prrtzel/MCD-Project/Rev1/Resources/Weekly Reports/MCD Weekly Report 2.docx

Microcomputer Design

Dr. Joonwan Kim

1/24/2024

Design Report #2

1. Total time spent this week: 6 hours (from this week and winter break)
2. Accomplishments
  a. I updated the schematic and got everything connected except power and the DUART
  b. Most of the parts are picked out and ready to go
3. Planned Work
  a. This week I plan to finish the schematic and BOM in order to start ordering parts as soon as possible.
  b. Any parts that are set in stone I will also go ahead and order this week.
4. Project Completion
  a. Hardware: 20%
  b. Software: 35% (program reads and writes to memory and displays the output)
