prrtzel/MCD-Project/Rev1/Resources/Weekly Reports/MCD Weekly Report 3.docx

Microcomputer Design

Dr. Joonwan Kim

1/30/2024

Design Report #3

1. Total time spent this week: 7.25 hours
2. Accomplishments
  a. I finished the schematic this week while fixing / verifying some interesting design choices
3. Planned Work
  a. This week I plan to purchase all of the parts
  b. I plan to start PCB design and pick out small parts (resistors, capacitors, etc.)
4. Project Completion
  a. Hardware: 30%
  b. Software: 35% (program reads and writes to memory and displays the output)
5. Help from Lab Tech
  a. 1/29/23 – asked questions about DUART rx and tx lines and received some guidance.
  b. 1/31/24 – Joao reviewed the schematic and corrected some decoupling capacitors and double checked everything
