prrtzel/MCD-Project/Rev2/HW/Altium/Imported MCD_Rev2/MCD_Rev2_1.png

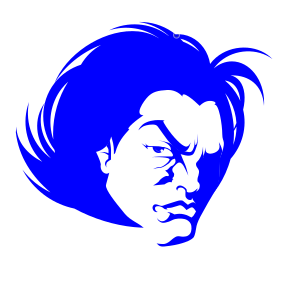
Rev2/HW/Altium/Imported MCD_Rev2/MCD_Rev2_1.png
