prrtzel/MCD-Project/Rev1/Resources/smallComponents.txt

small components
0805 capacitors and LED's
