prrtzel/MCD-Project/Rev2/HW/imported/CLOCK/ECS-100AX-080.step

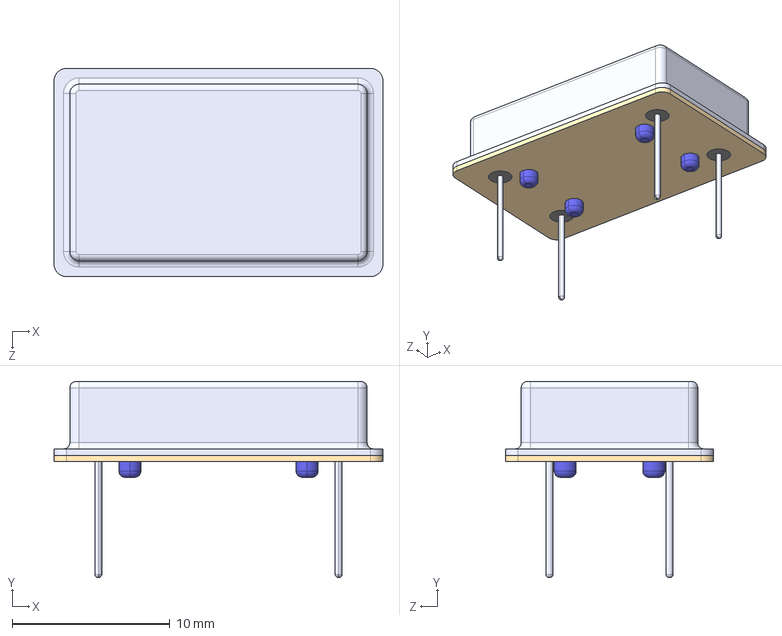
[picture p2: CAD file, 2024-04-25]
Rev2/HW/imported/CLOCK/ECS-100AX-080.step
20.9 x 12.4 x 13.2 mm
