prrtzel/MCD-Project/Rev2/HW/imported/CONNECTOR/18PIN/TD-109-T-A.step

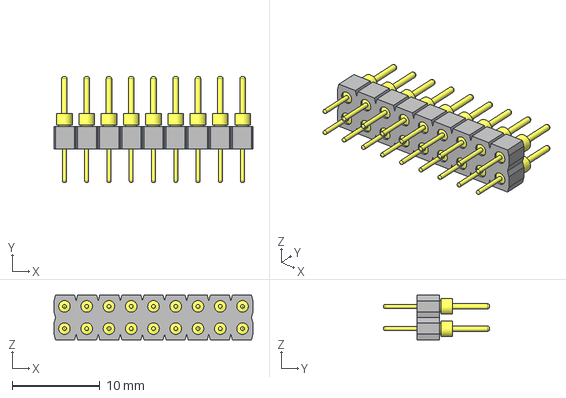
[picture p3: CAD file, 2024-04-25]
Rev2/HW/imported/CONNECTOR/18PIN/TD-109-T-A.step
22.7 x 12.1 x 5.08 mm
TD-109-G-A_socket
-101-G-A_pins x 18
