prrtzel/MCD-Project/Rev2/HW/imported/CONNECTOR/2PIN/TS-102-T-A.step

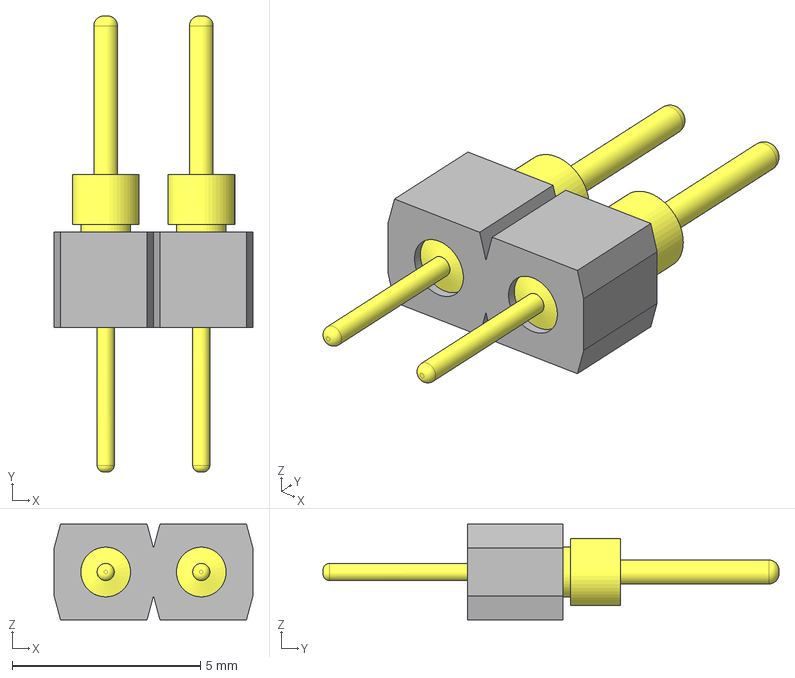
[picture p4: CAD file, 2024-04-25]
Rev2/HW/imported/CONNECTOR/2PIN/TS-102-T-A.step
5.28 x 12.1 x 2.54 mm
TS-102-G-A_socket
-101-G-A_pins x 2
