prrtzel/MCD-Project/Rev2/HW/imported/CONNECTOR/4PIN/TS-104-T-A.step

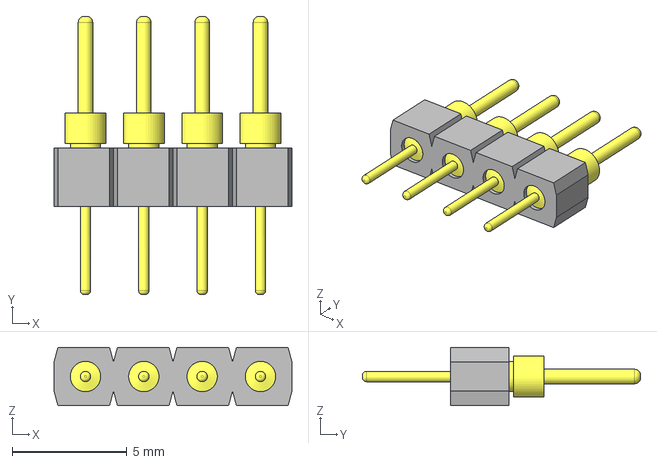
[picture p5: CAD file, 2024-04-25]
Rev2/HW/imported/CONNECTOR/4PIN/TS-104-T-A.step
10.4 x 12.1 x 2.54 mm
TS-104-G-A_socket
-101-G-A_pins x 4
