prrtzel/MCD-Project/Rev2/HW/imported/CONNECTOR/6PIN/TS-106-T-A.step

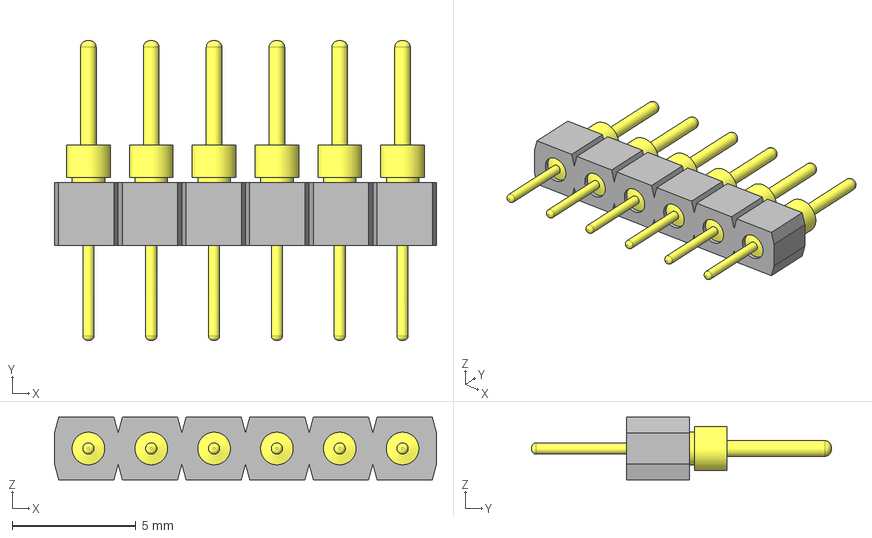
[picture p6: CAD file, 2024-04-25]
Rev2/HW/imported/CONNECTOR/6PIN/TS-106-T-A.step
15.4 x 12.1 x 2.54 mm
TS-106-G-A_socket
-101-G-A_pins x 6
