prrtzel/MCD-Project/Rev2/HW/imported/CONNECTOR/8PIN/TS-108-T-A.step

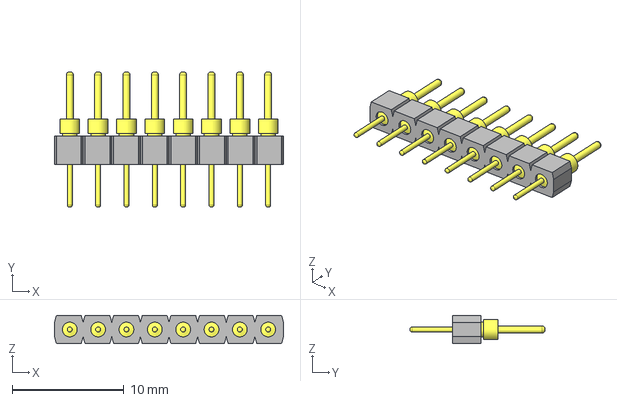
[picture p7: CAD file, 2024-04-25]
Rev2/HW/imported/CONNECTOR/8PIN/TS-108-T-A.step
20.5 x 12.1 x 2.54 mm
TS-108-G-A_socket
-101-G-A_pins x 8
