prrtzel/MCD-Project/Rev2/HW/imported/CPLD/44-VQFP_XIL.step

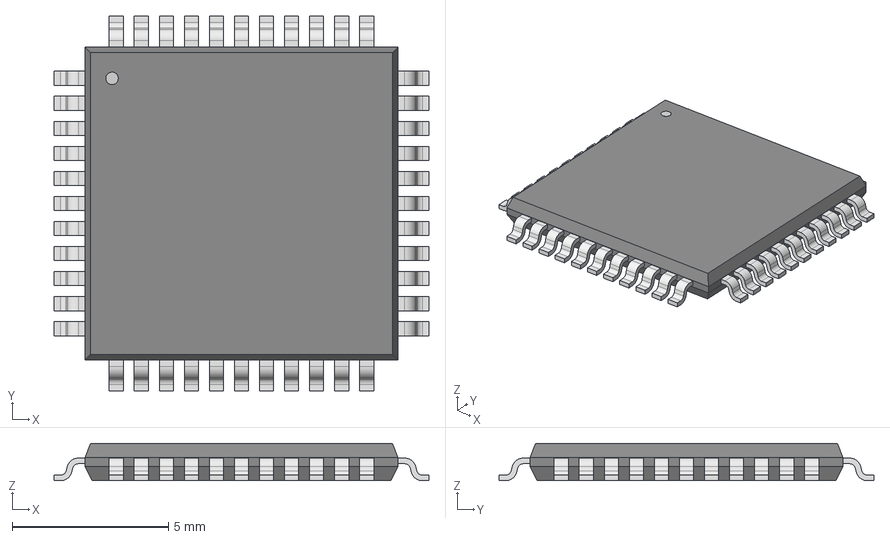
[picture p8: CAD file, 2024-04-25]
Rev2/HW/imported/CPLD/44-VQFP_XIL.step
12.0 x 12.0 x 1.20 mm
