prrtzel/MCD-Project/Rev2/HW/imported/DEBOUNCER/MAX6816EUS_T.step

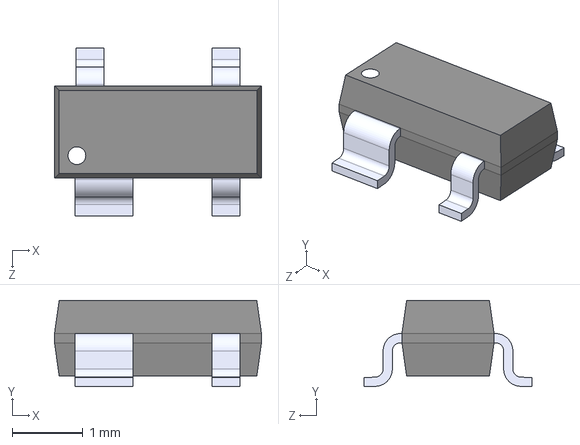
[picture p9: CAD file, 2024-04-25]
Rev2/HW/imported/DEBOUNCER/MAX6816EUS_T.step
2.92 x 1.22 x 2.37 mm
