prrtzel/MCD-Project/Rev2/HW/imported/DUART/PLCC-44.step

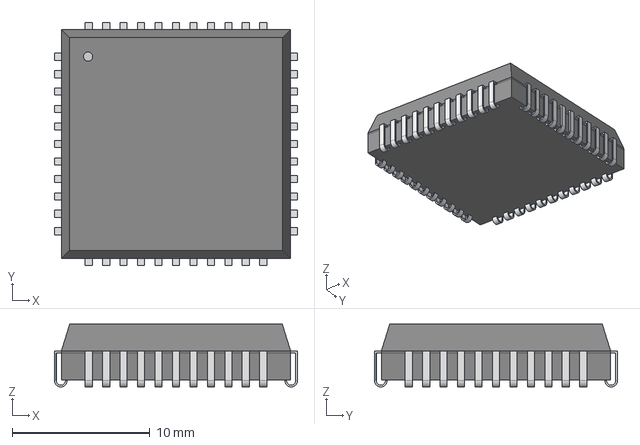
[picture p10: CAD file, 2024-04-25]
Rev2/HW/imported/DUART/PLCC-44.step
17.7 x 17.7 x 4.58 mm
