prrtzel/MCD-Project/Rev2/HW/imported/LDO/SOT-223_DIO.step

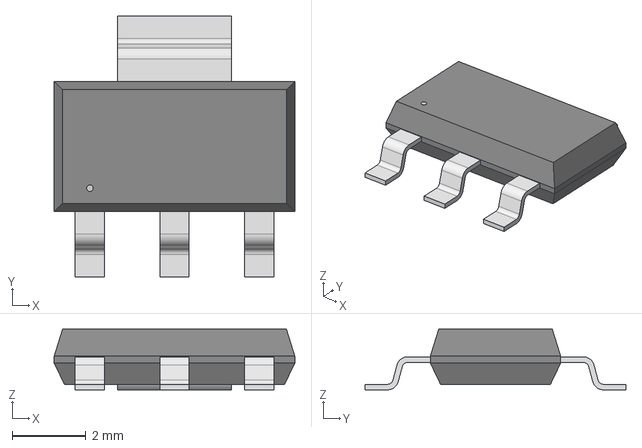
[picture p11: CAD file, 2024-04-25]
Rev2/HW/imported/LDO/SOT-223_DIO.step
6.55 x 7.10 x 1.65 mm
