prrtzel/MCD-Project/Rev2/HW/imported/RESETSUPERVISOR/SOT-23_STM.step

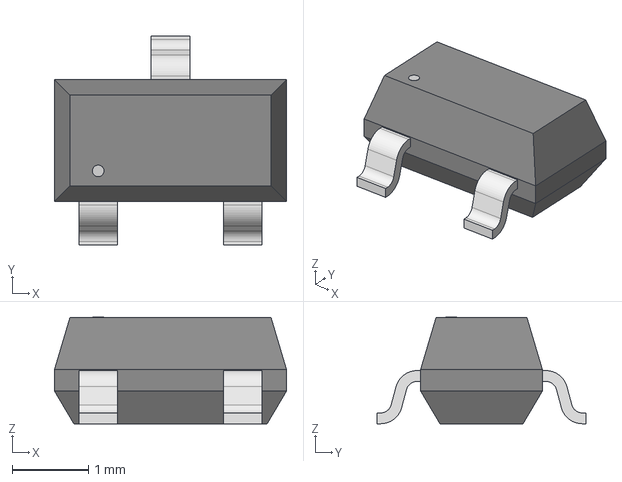
[picture p12: CAD file, 2024-04-25]
Rev2/HW/imported/RESETSUPERVISOR/SOT-23_STM.step
3.05 x 2.74 x 1.40 mm
