prrtzel/MCD-Project/Rev2/HW/imported/ROM/KiCADv6/3DmODELS/PDIP32_PH_SST_MCH.step

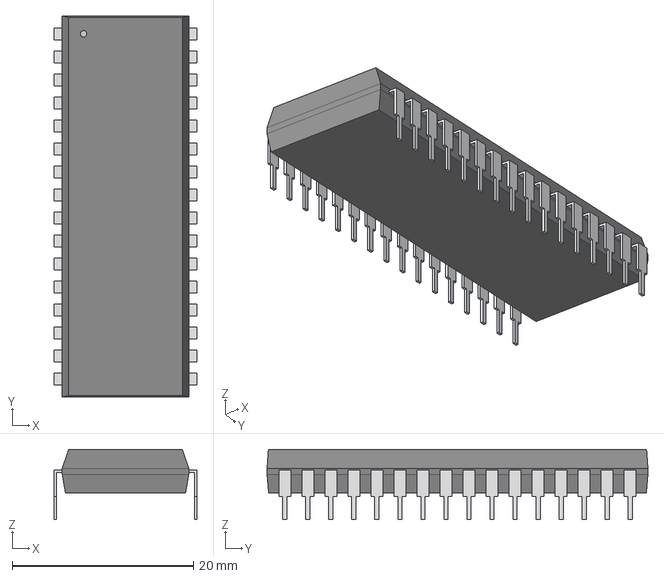
[picture p13: CAD file, 2024-04-25]
Rev2/HW/imported/ROM/KiCADv6/3DmODELS/PDIP32_PH_SST_MCH.step
15.7 x 42.0 x 7.75 mm
