prrtzel/MCD-Project/(list of files, cad)

Other CAD files:
Rev2/HW/imported/44PINPLCC/Concept/2024_02_02_16_16_22/exported/8444_11b1_rk_tp/chips/chips.prt
