prrtzel/MCD-Project/Rev1/Resources/things to assemble on jlc.txt

things to assemble from jlc
- voltage regulator
- debouncer
