prrtzel/MCD-Project/Rev1/Resources/George Yacoubian MCD Final Schematic Rev 1.pdf

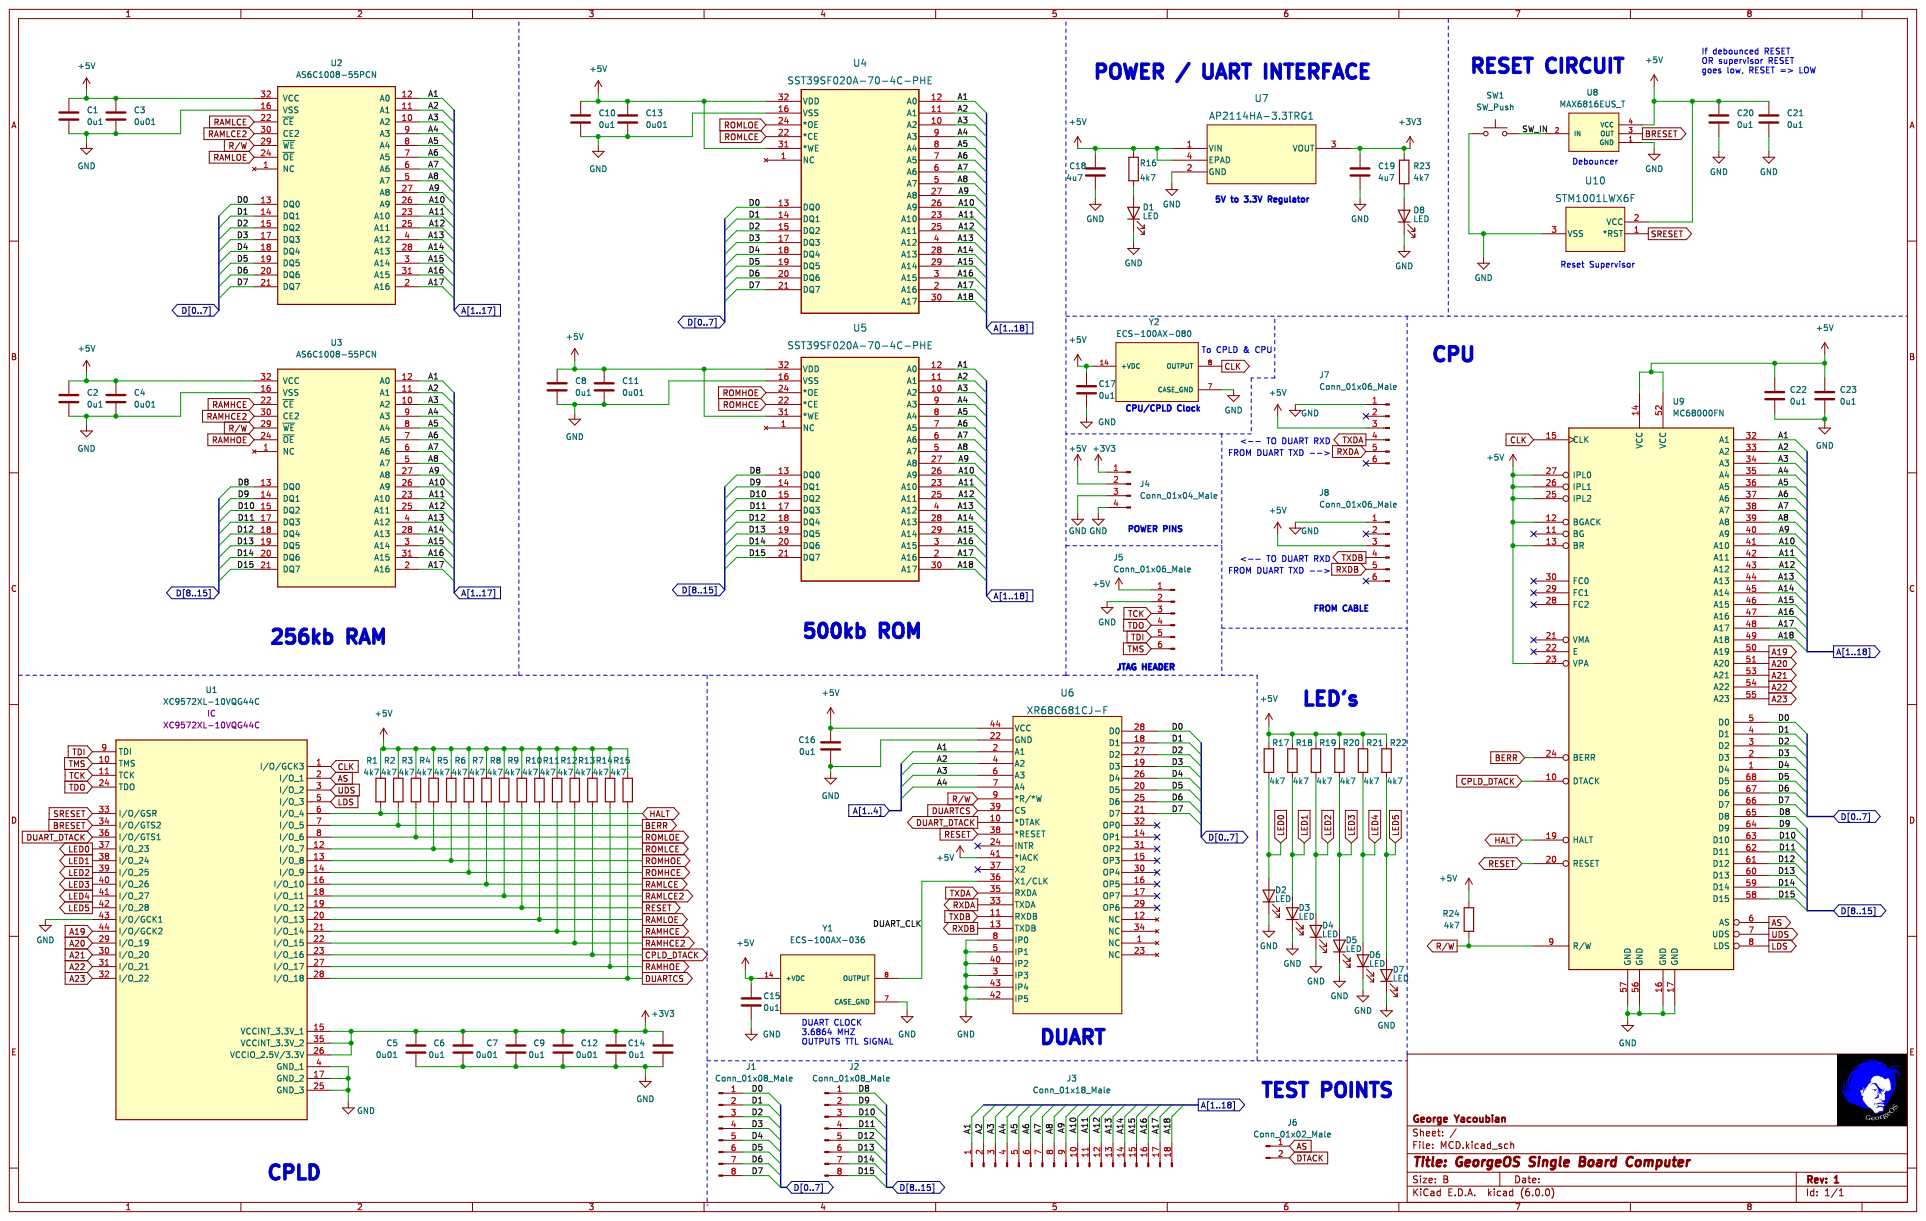
[picture p14: page 1]
