prrtzel/MCD-Project/(list of files, drawings)

Other design files:
Rev2/HW/Altium/Imported MCD_Rev2/2024-01-01_18-42-48.SchLib
Rev2/HW/Altium/Imported MCD_Rev2/2024-01-01_20-53-31.SchLib
Rev2/HW/Altium/Imported MCD_Rev2/2024-01-20_19-14-39.SchLib
Rev2/HW/Altium/Imported MCD_Rev2/2024-01-23_20-40-36.SchLib
Rev2/HW/Altium/Imported MCD_Rev2/2024-01-24_16-15-17.SchLib
Rev2/HW/Altium/Imported MCD_Rev2/2024-02-02_16-16-25.SchLib
Rev2/HW/Altium/Imported MCD_Rev2/2024-02-03_23-22-11.SchLib
Rev2/HW/Altium/Imported MCD_Rev2/2024-02-03_23-24-29.SchLib
Rev2/HW/Altium/Imported MCD_Rev2/2024-02-03_23-24-37.SchLib
Rev2/HW/Altium/Imported MCD_Rev2/2024-02-03_23-24-40.SchLib
Rev2/HW/Altium/Imported MCD_Rev2/2024-02-03_23-26-54.SchLib
Rev2/HW/Altium/Imported MCD_Rev2/8468-11B1-RK-TP.SchLib
Rev2/HW/Altium/Imported MCD_Rev2/AS6C1008-55PCN.SchLib
Rev2/HW/Altium/Imported MCD_Rev2/ECS-100AX-036.SchLib
Rev2/HW/Altium/Imported MCD_Rev2/ECS-100AX-080.SchLib
Rev2/HW/Altium/Imported MCD_Rev2/MAX6816EUS_T.SchLib
Rev2/HW/Altium/Imported MCD_Rev2/MCD_Rev2.PcbDoc
Rev2/HW/Altium/Imported MCD_Rev2/MCD_Rev2.PrjPcb
Rev2/HW/Altium/Imported MCD_Rev2/MCD_Rev2.SchDoc
Rev2/HW/Altium/Imported MCD_Rev2/MCD_Rev2.SchLib
