prrtzel/MCD-Project/(commit log)

2023-11-21 added assembly file
2023-12-12 print function implemented
2023-12-12 added stack control for serial print function
2023-12-12 added a print word function for conversion
2023-12-13 scratch last, prints 2 bytes instead of one
2024-01-31 ROUGH DRAFT SCHEMATIC
    [44-VQFP_XIL.step, BOM.xlsx, ECS-100AX-036.step, ECS-100AX-080.step, MAX6816EUS_T.step, MCD.kicad_pcb, MCD.kicad_sch, PDIP32_PH_SST_MCH.step]
2024-02-02 updated GeorgeOS makefile
    [BOM.xlsx, MCD.kicad_sch, Time Log.xlsx]
2024-02-12 last revision with vbcc
    [MCD.kicad_pcb, MCD.kicad_sch, chips.prt]
2024-02-16 working on pcb
    [MCD.kicad_pcb, MCD.kicad_sch, TD-109-T-A.step, TS-102-T-A.step, TS-104-T-A.step, TS-106-T-A.step, TS-108-T-A.step]
2024-02-16 I NEED TO TAKE BRAKE
    [MCD.kicad_pcb, MCD.kicad_sch]
2024-02-16 finished data bus
    [MCD.kicad_pcb]
2024-02-16 DO NOT CHANGE THIS BISCUIT PARAMETERS
    [MCD.kicad_pcb]
2024-02-16 HALF OF ABUS
    [MCD.kicad_pcb]
2024-02-17 abus done, working on dbus
    [MCD.kicad_pcb]
2024-02-17 abus and dbus done
    [MCD.kicad_pcb]
2024-02-17 abus and dbus double done
    [MCD.kicad_pcb]
2024-02-17 updated pcb
    [MCD.kicad_pcb]
2024-02-17 AHHH THE BUS WAS NOT CONNECTD THAMK YOU GF FOR POINTYING THAT ORUT
    [MCD.kicad_pcb]
2024-02-17 KICAD WAS GOOFY! anyuways decode bus is done, routing control bus
    [MCD.kicad_pcb, MCD.kicad_sch]
2024-02-17 control bus almost done
    [MCD.kicad_pcb]
2024-02-17 everything but power connected
    [MCD.kicad_pcb, MCD.kicad_sch]
2024-02-18 FINISHED!!! (I THINK)
    [MCD.kicad_pcb, MCD.kicad_sch]
2024-02-18 REV 1 OUT
    [MCD.kicad_pcb]
2024-02-18 board and parts ordered
    [JLCPCB_GEORGEOS_BOM.xls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]
2024-02-26 IT FREAKING LINKS AND WORKS
    [JLCPCB_GEORGEOS_BOM.xls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]
2024-03-04 linker now sees main symbol
    [MCD.kicad_pcb]
2024-03-12 worked on string stuff
    [glue_logic_pad.csv]
2024-03-13 read mem now prints value instead of returning one
2024-03-23 changed xc9572xl schematic symbol from vq44 to pc44
    [MCD.kicad_pcb, MCD.kicad_sch, glue_logic_pad.csv]
2024-03-24 finished pcb, not checked yet but drc is good
    [MCD.kicad_pcb, MCD.kicad_sch]
2024-03-25 now converts to hex to bin and bin to hex
    [MCD-B_Cu.gbr, MCD-B_Mask.gbr, MCD-B_Paste.gbr, MCD-B_Silkscreen.gbr, MCD-Edge_Cuts.gbr, MCD-F_Cu.gbr, MCD-F_Mask.gbr, MCD-F_Paste.gbr]
2024-04-06 finished duart test code, not tested
    [glue_logic_pad.csv]
2024-04-09 added vector stuff in test rx now rwx for ram
    [glue_logic_pad.csv]
2024-04-15 changed adecodiign
    [MCD.kicad_pcb, glue_logic_pad.csv]
2024-04-19 rom and ram test work, working on integrating bare bones C
    [glue_logic_pad.csv]
2024-04-19 putchar works in asm
    [glue_logic_pad.csv]
2024-04-19 back to og state, can recive but not transmit in getchar
    [glue_logic_pad.csv]
2024-04-25 wrapping it up for SP2024, now for Rev2
    [44-VQFP_XIL.step, BOM.xlsx, ECS-100AX-036.step, ECS-100AX-080.step, MAX6816EUS_T.step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]
2024-05-27 added morg files
    [MCD.kicad_pcb]
2024-06-10 started via stitching
    [MCD_Rev2.kicad_pcb]
2024-06-11 finished signals and power, need to via stitch
    [MCD_Rev2.kicad_pcb]
2024-06-12 spaced out traces
    [MCD_Rev2.kicad_pcb]
2024-06-12 spaced out traces EVEN MORE
    [MCD_Rev2.kicad_pcb]
2024-06-12 filled in POURS
    [MCD_Rev2.kicad_pcb]
2024-06-13 added via stitching, now adjusting silkscreen
    [MCD_Rev2.kicad_pcb]
2024-06-13 via stitching done, adjusting silscreen
    [2024-01-01_18-42-48.SchLib, 2024-01-01_20-53-31.SchLib, 2024-01-20_19-14-39.SchLib, 2024-01-23_20-40-36.SchLib, 2024-01-24_16-15-17.SchLib, 2024-02-02_16-16-25.SchLib, 2024-02-03_23-22-11.SchLib, 2024-02-03_23-24-29.SchLib]
2024-06-13 pcb draft done, waiting for input from profreshonal
    [MCD_Rev2.kicad_pcb]
2024-06-17 memory is still a bit wack, making conversions so that we can debug that
    [MCD_Rev2.kicad_pcb]
2024-06-19 load_srec implemented
    [MCD_Rev2.kicad_pcb]
2024-06-19 finished pcb
    [MCD_Rev2.kicad_pcb, MCD_Rev2.kicad_sch]
2024-06-19 generated gerber files for rev3
    [MCD_Rev2-B_Cu.gbr, MCD_Rev2-B_Mask.gbr, MCD_Rev2-B_Paste.gbr, MCD_Rev2-B_Silkscreen.gbr, MCD_Rev2-Edge_Cuts.gbr, MCD_Rev2-F_Cu.gbr, MCD_Rev2-F_Mask.gbr, MCD_Rev2-F_Paste.gbr]
2024-06-21 added support for better commands and finished pcb rev3
    [MCD_Rev2-B_Cu.gbr, MCD_Rev2-B_Mask.gbr, MCD_Rev2-B_Paste.gbr, MCD_Rev2-B_Silkscreen.gbr, MCD_Rev2-Edge_Cuts.gbr, MCD_Rev2-F_Cu.gbr, MCD_Rev2-F_Mask.gbr, MCD_Rev2-F_Paste.gbr]
2024-06-28 working on getting cpld to work
    [glue_logic_pad.csv]
