prrtzel/MCD-Project/(notices)

Notices in the files:
Rev2/HW/imported/CONNECTOR/4PIN/TS-104-T-A.step:
author */ ('License CC BY-ND 4.0'),
